Ingenion/tvs3docs/README.md

# Setup

This repo for documentation was created using the steps in the following tutorial.

To get started, follow [this Sphinx tutorial](https://olgarithms.github.io/sphinx-tutorial/).

To create a new Ingenion documentation repo, clone this one and use steps in the tutorial above to setup your local workspace, as needed.

# Building the document
1. ```cd``` to the root folder
2. ```source venv/bin/activate```
3. ```cd docs```
3. ```make html```
4. Open the ```docs/_build/html/index.html``` file
