Ingenion/tvs3docs/docs/overview/module_set.rst

.. _module_set:

Module Set
==========
The following modules are available for the TVS 3.0 mainframe from Ingenion's eStore.  Module templates (electrical and mechanical) are freely provided by Ingenion allowing users to create their own custom modules.

Modules provide the physical interface to the outside world and can be used to add functionality to the TVS 3.0 mainframe.  Modules can be easily swapped in and out of the mainframe allowing users to quickly change the functionality of the system.  Modules are paired with FPGA logic blocks and/or software running on the Raspberry Pi-5 module to provide a complete solution for a wide range of applications. 

SpaceWire I/O Module
--------------------
This module provides SpaceWire-compliant connectors and LVDS transceivers for high-speed serial communication.  The module supports data rates up to 200 Mbps and is ideal for space applications requiring reliable and low-latency communication.

LVDS I/O Module
---------------
This module provides a set of LVDS transceivers and connectors for high-speed differential signaling.  The module supports data rates up to 400 Mbps and is suitable for custom applications requiring high-speed data transfer with low noise and interference.

RS-422 I/O Module
-----------------
This module provides RS-422 transceivers and connectors for differential serial communication.  The module supports data rates up to 10 Mbps and is ideal for industrial and commercial applications requiring robust and long-distance communication.

RS-485 I/O Module
-----------------
This module provides RS-485 transceivers and connectors for differential serial communication.  The module supports data rates up to 10 Mbps and is suitable for industrial and commercial applications requiring multi-point communication over long distances.

LVTTL I/O Module
----------------
This module provides LVTTL transceivers and connectors for single-ended digital signaling.  The module is ideal for general-purpose digital I/O applications.

CAN I/O Module 
--------------
This module provides CAN transceivers and connectors for Controller Area Network (CAN) communication.  The module supports data rates up to 1 Mbps and is ideal for automotive and industrial applications requiring robust and reliable communication.

Ethernet PHY Module
-------------------
This module provides Ethernet PHY and RJ45 connectors for 10/100/1000 Mbps Ethernet communication.  The module is suitable for applications requiring network connectivity and high-speed data transfer.

SpaceFibre I/O Module 
---------------------
This module provides SpaceFibre-compliant connectors and transceivers for high-speed serial communication.  The module supports data rates up to 6.25 Gbps and is ideal for space applications requiring high-bandwidth and low-latency communication.
