Ingenion/tvs3docs/docs/mainframe/pwr_mass_size.rst

Power, Mass, Size
=================

Power 
-----
The TVS 3.0 mainframe requires a +12V DC power supply. Power is received on either J6 or J9 (not both) on the back side of the enclosure.  A minimum current rating of 3A (TBD) is recommended to ensure proper operation.  

Custom modules may be designed to accept additional power inputs, as needed.  Please refer to the module design guidelines for more information regarding grounding and IO standards.

Mass 
----
The TVS 3.0 mainframe has a mass of approximately 3 kg (TBD).  This only includes the mainframe enclosure without any modules.

Size 
----
The TVS 3.0 mainframe has the following dimensions: 
   - Height: 3u - 5.25" (133.35 mm)
   - Width:  19" (482.6 mm)
   - Depth:  6.89" (175mm)

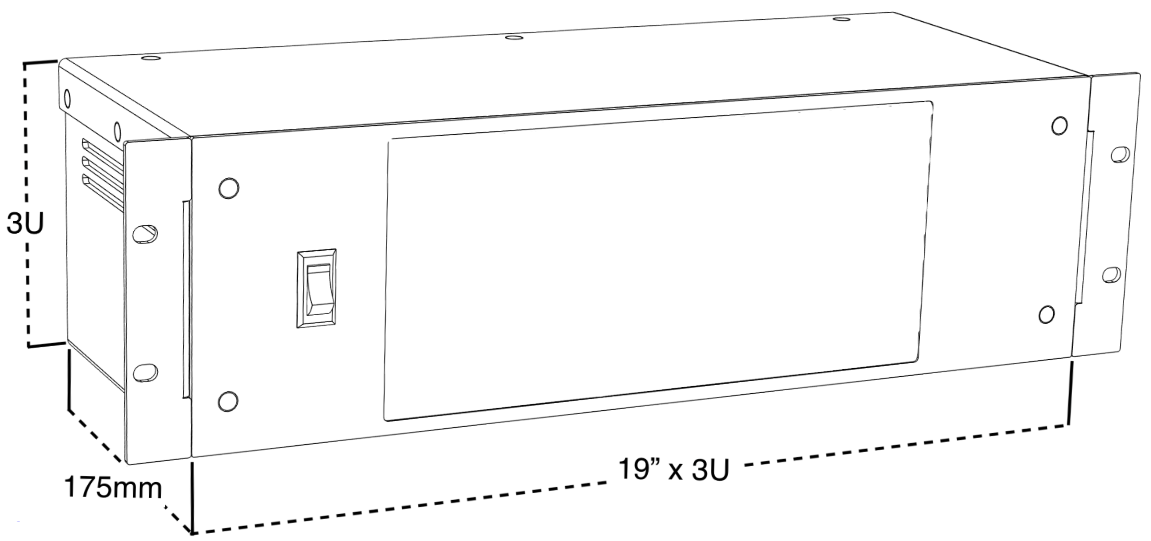
[picture p2: images/pwr_mass_size/enclosure/angled.png]


Mounting Options 
----------------
The TVS 3.0 mainframe can be mounted in a standard 19" equipment rack using the optional rack ears and hardware.  

Without rack ears the mainframe is used on a benchtop or other non-rack environment.
