Ingenion/tvs3docs/docs/modules/module_template.rst

.. _module_template:

Module Template
===============

Board Outline
-------------

Power
-----

Edge Connector and Pinout
-------------------------
While the bit file is loaded into the FPGA, pins are floating.  Be sure to design the module with pull-ups or pull-downs to prevent any undesired effects.

Connector Plate
---------------

Engineering Files
-----------------
