Ingenion/tvs3docs/docs/modules/analog_in.rst

Analog Inputs 
=============

Features
--------

Connectors
----------

Operation
---------
