Ingenion/tvs3docs/docs/modules/analog_out.rst

Analog Outputs 
==============

Features
--------

Connectors
----------

Operation
---------
