Ingenion/tvs3docs/docs/modules/can.rst

CAN 
===

Features
--------

Connectors
----------

Operation
---------
