Ingenion/tvs3docs/docs/modules/ethernet.rst

Gigabit Ethernet Module
=======================

Features
--------

Connectors
----------

Operation
---------
