Ingenion/tvs3docs/docs/modules/lvds.rst

LVDS Module
===========

Features
--------

Connectors
----------

Operation
---------
