Ingenion/tvs3docs/docs/modules/lvttl.rst

LVTTL 
=====

Features
--------

Connectors
----------

Operation
---------
