Ingenion/tvs3docs/docs/modules/rs422.rst

RS-422 
======

Features
--------

Connectors
----------

Operation
---------
