Ingenion/tvs3docs/docs/modules/rs485.rst

RS-485 
======

Features
--------

Connectors
----------

Operation
---------
