Ingenion/tvs3docs/docs/modules/spacefibre.rst

SpaceFibre Module
=================

Features
--------

Connectors
----------

Operation
---------
