Ingenion/tvs3docs/docs/modules/spacewire.rst

SpaceWire
=========

Features
--------

Connectors
----------

Operation
---------
