Ingenion/tvs3docs/images/3d-models/module_pcb_dims.pdf

150

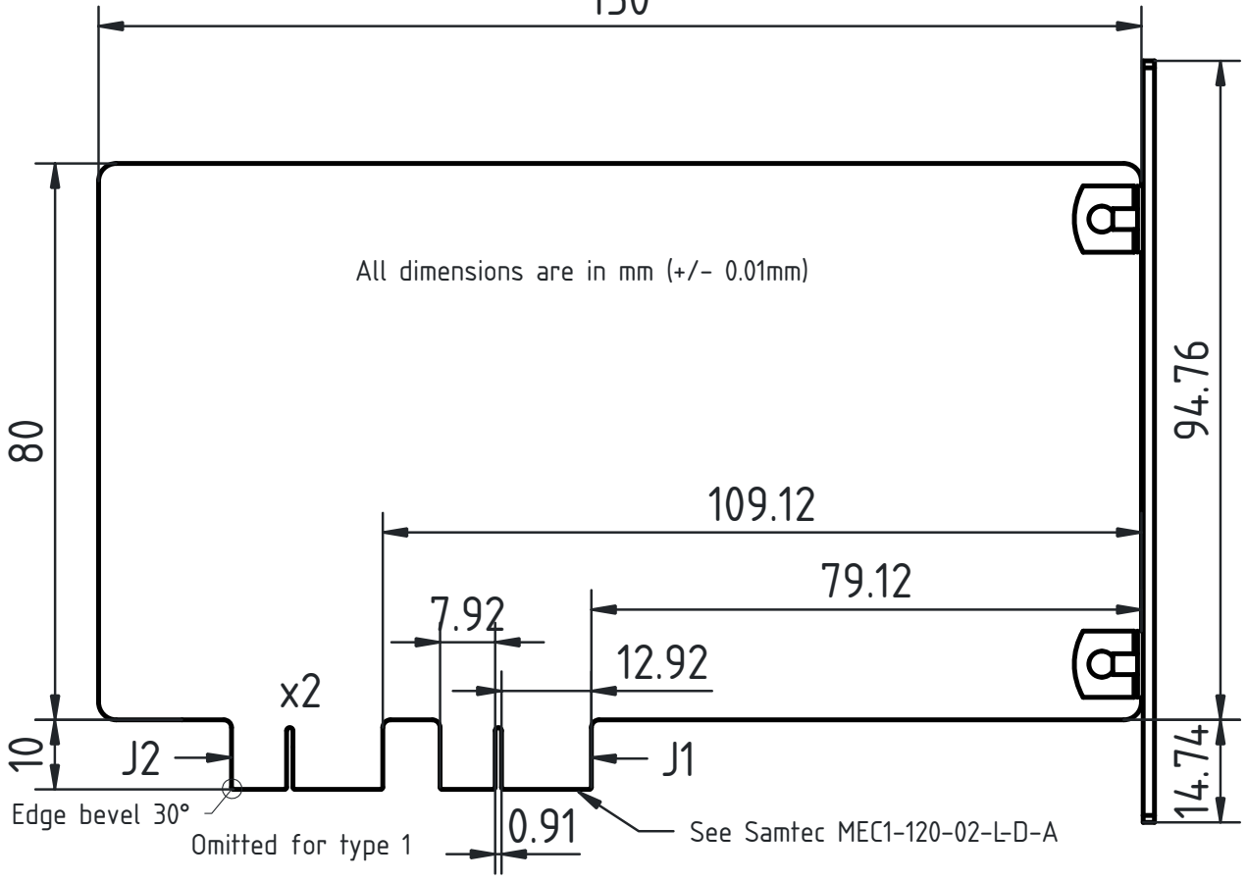
[picture p3: figure]
All dimensions are in mm (+/- 0.01mm); Edge bevel 30°

See Samtec MEC1-120-02-L-D-A Omitted for type 1
