Ingenion/tvs3docs/images/pwr_mass_size/enclosure/angled.pdf

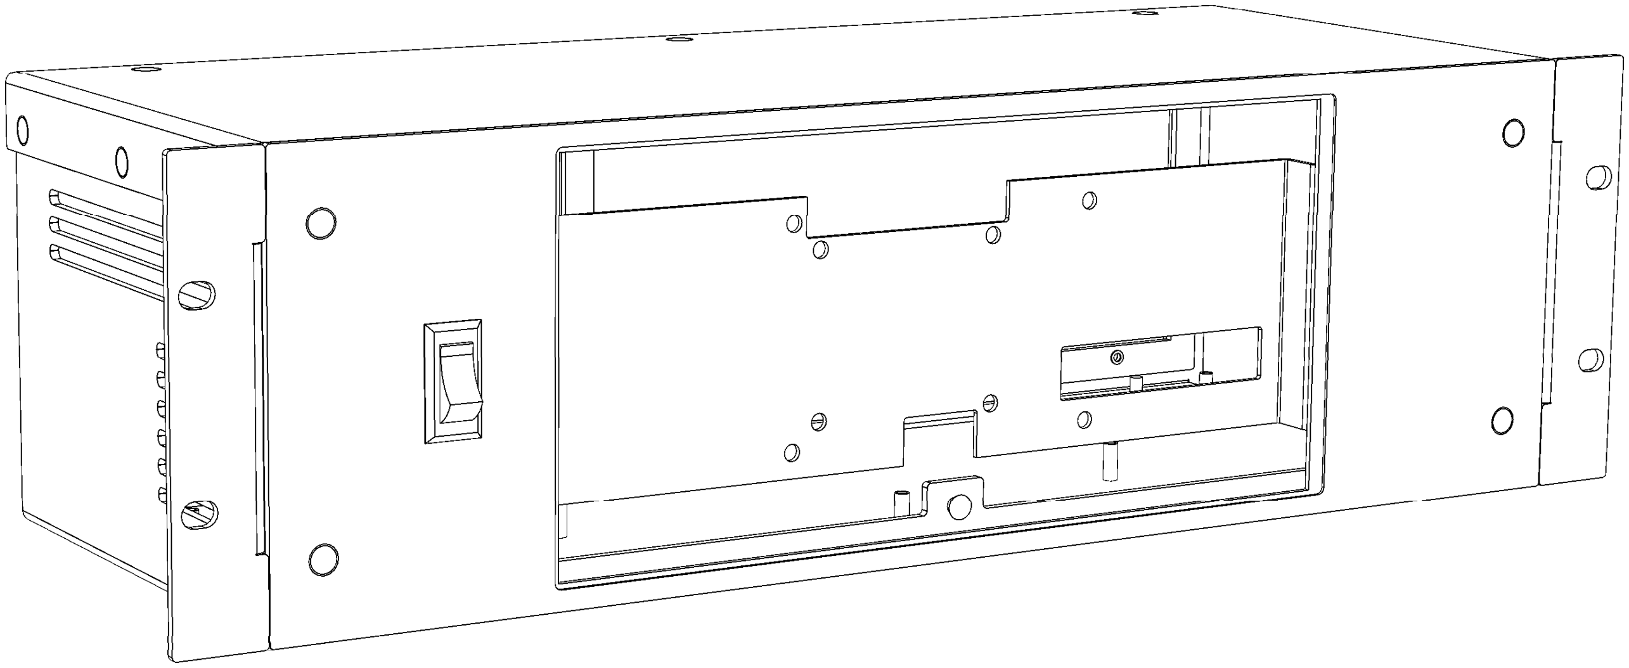
[picture p18: figure]
