Ingenion/tvs3docs/images/pwr_mass_size/enclosure/back.pdf

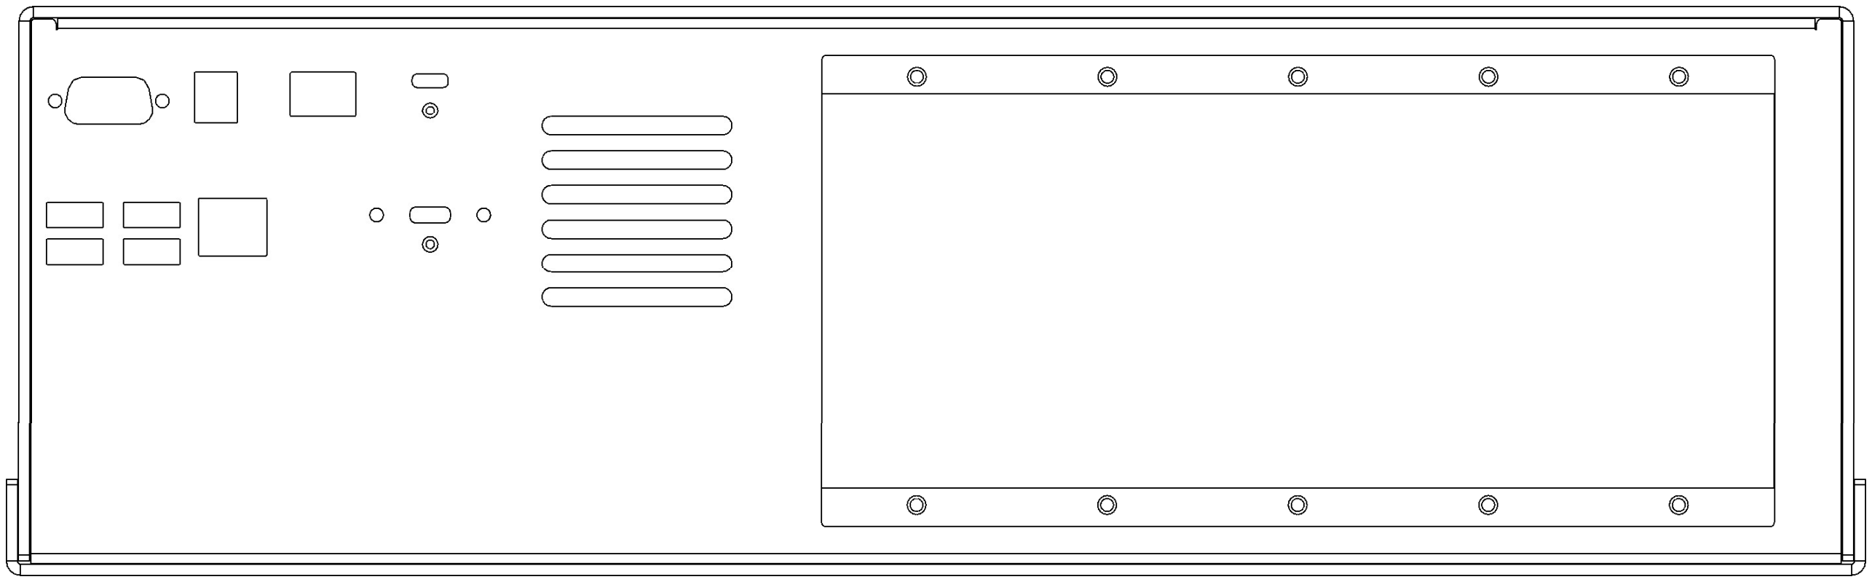
[picture p19: figure]
