Ingenion/tvs3docs/images/pwr_mass_size/enclosure/left.pdf

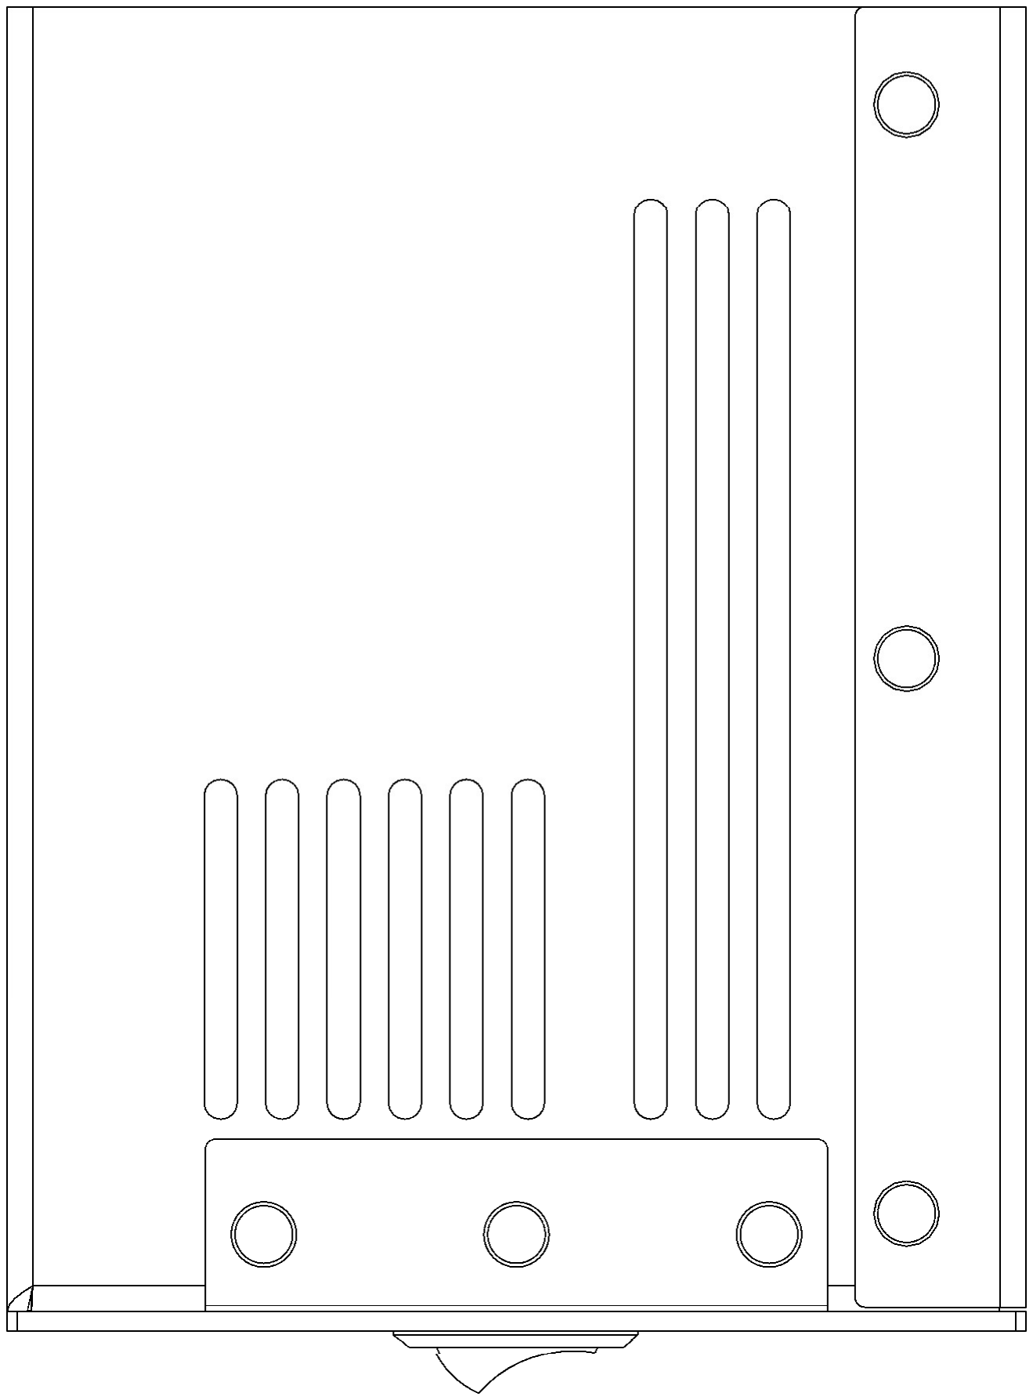
[picture p21: figure]
