Ingenion/tvs3docs/images/pwr_mass_size/enclosure/right.pdf

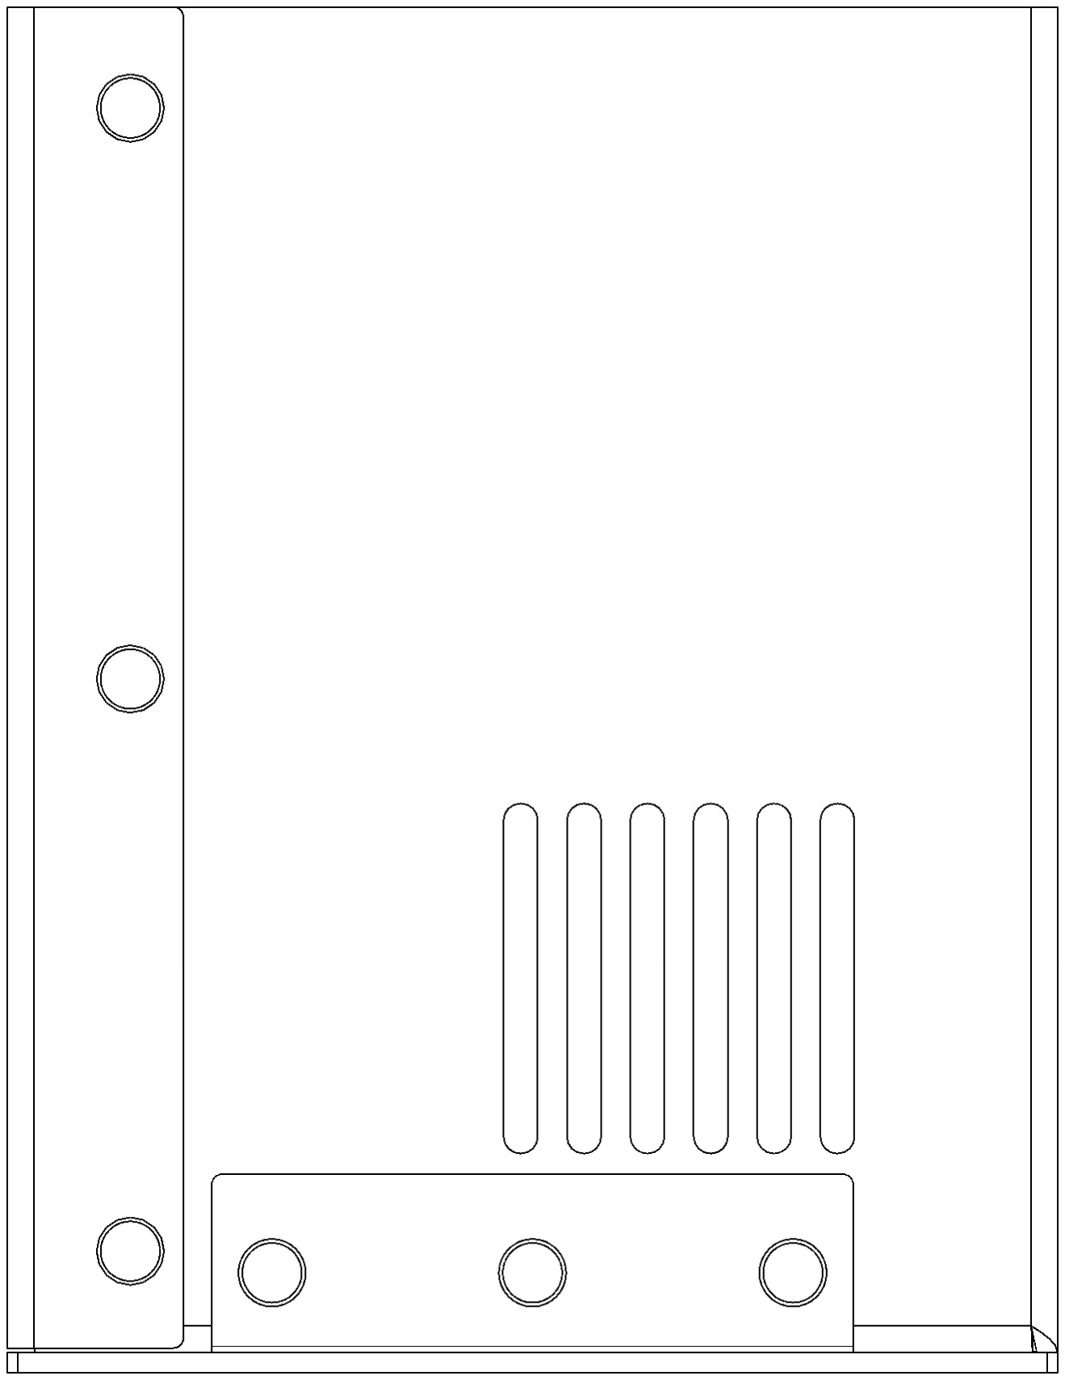
[picture p22: figure]
