Ingenion/tvs3docs/images/pwr_mass_size/enclosure/top.pdf

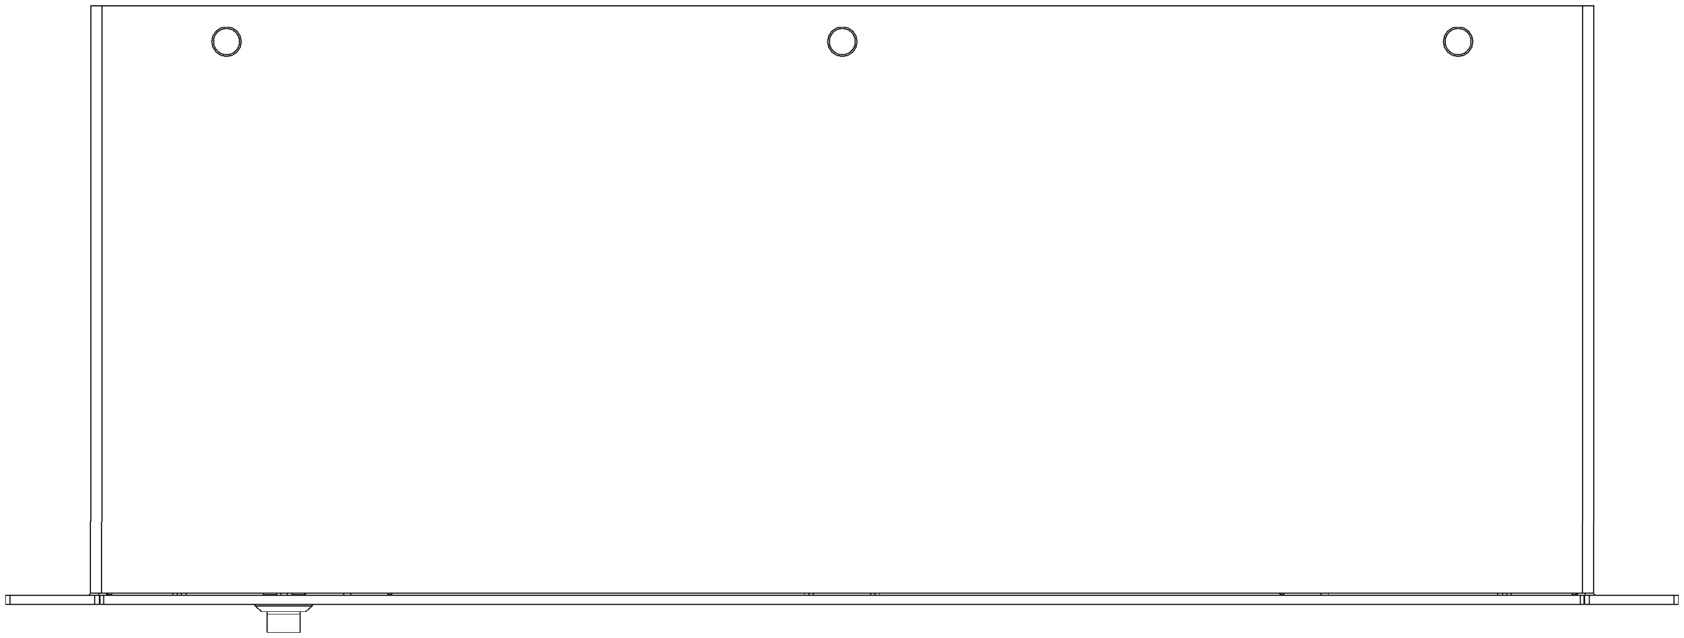
[picture p23: figure]
