Ingenion/tvs3docs/images/mainframe/module_envelope.png

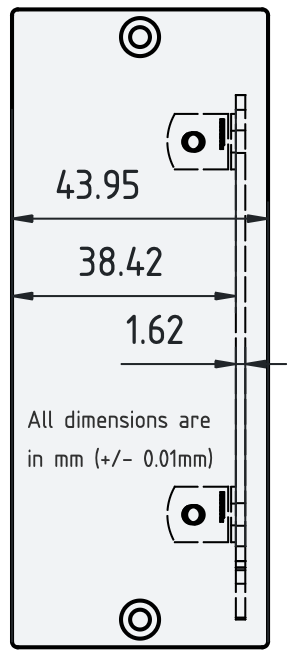
images/mainframe/module_envelope.png
