Ingenion/tvs3docs/images/pwr_mass_size/enclosure/back.png

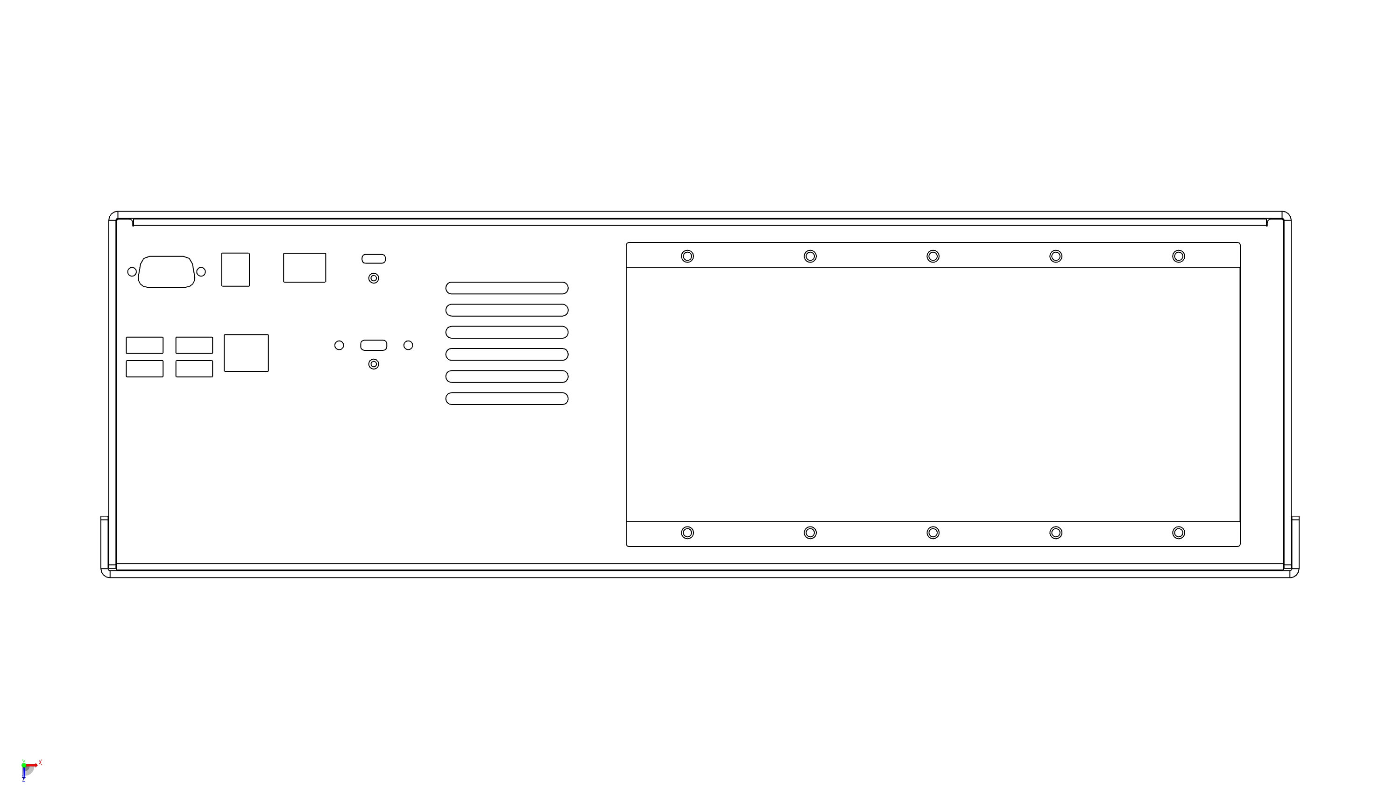
images/pwr_mass_size/enclosure/back.png
