Ingenion/tvs3docs/images/pwr_mass_size/enclosure/front.png

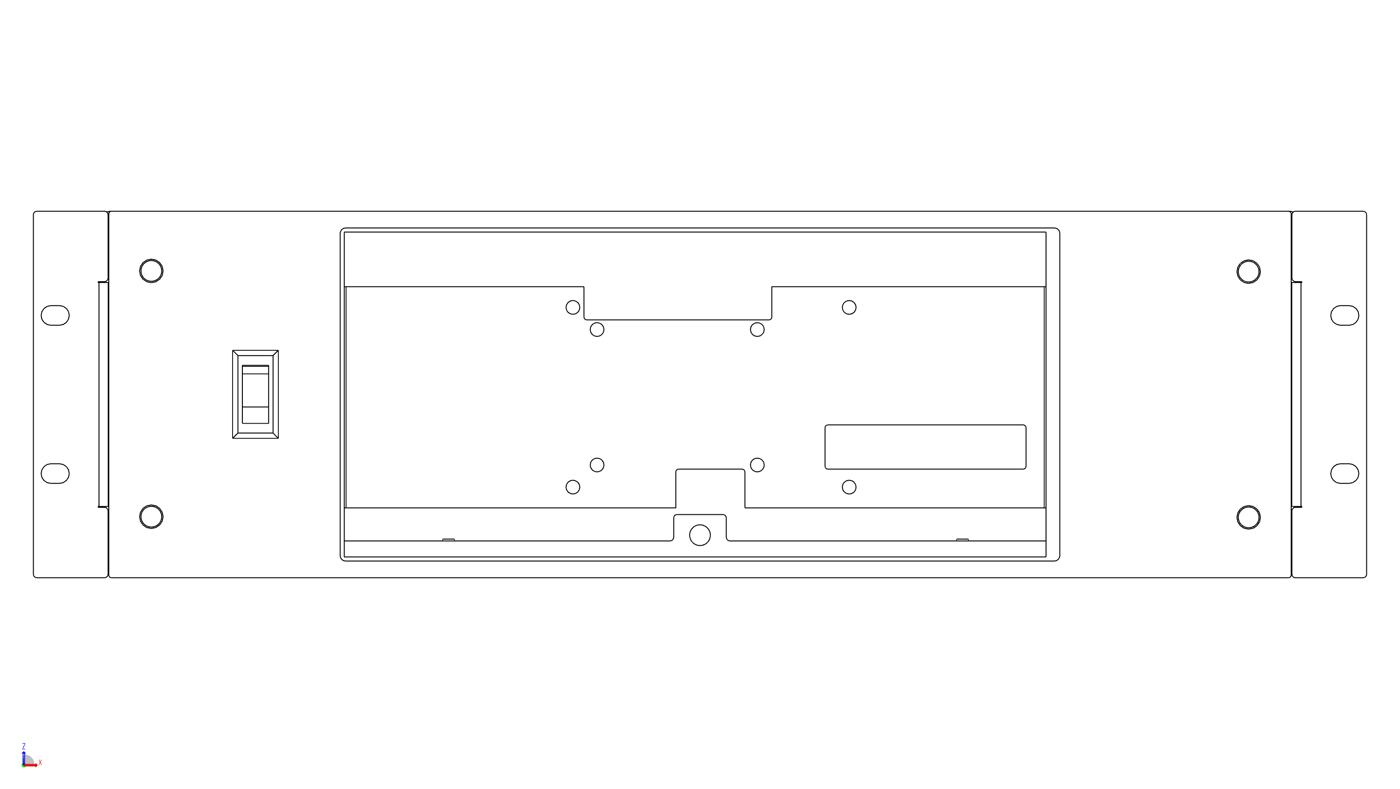
images/pwr_mass_size/enclosure/front.png
