Ingenion/tvs3docs/images/pwr_mass_size/enclosure/left.png

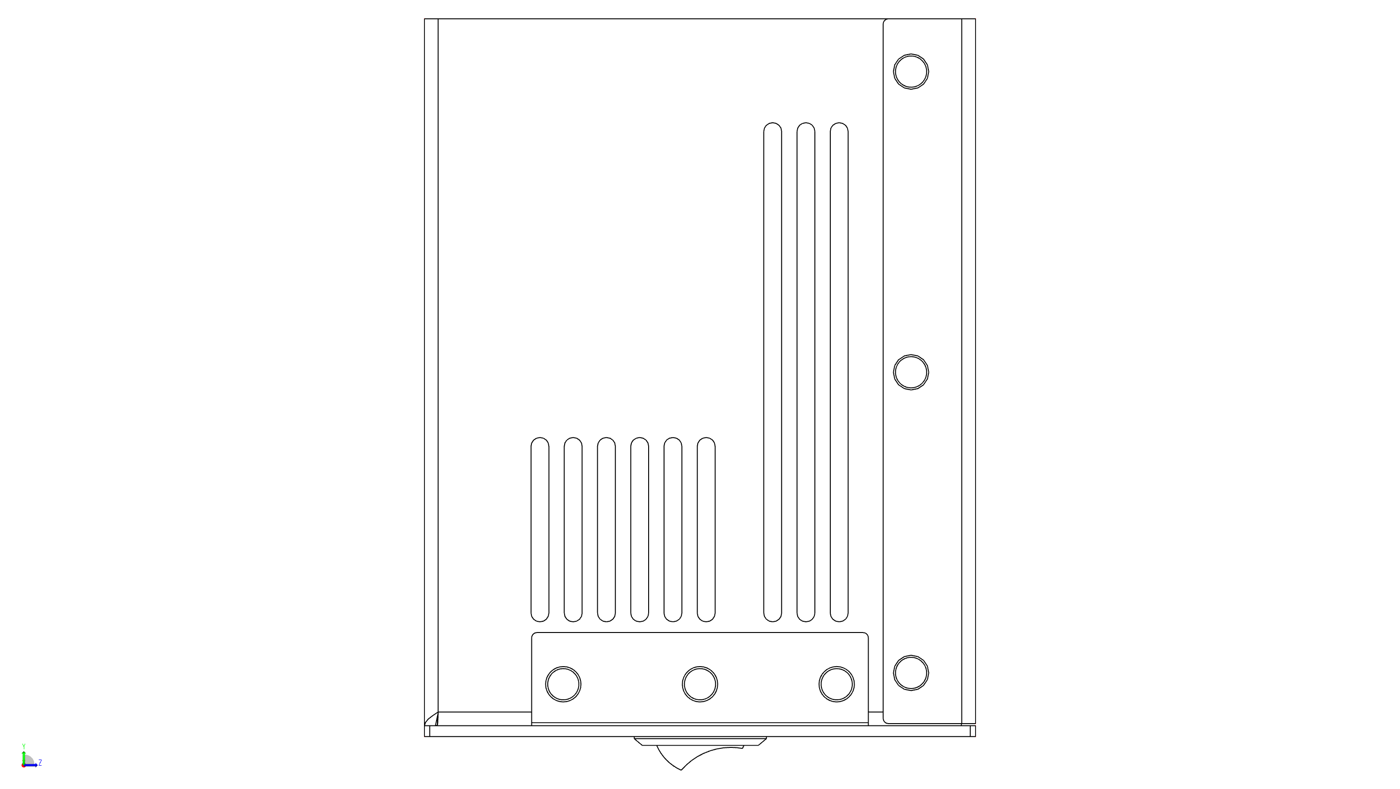
images/pwr_mass_size/enclosure/left.png
