Ingenion/tvs3docs/images/pwr_mass_size/enclosure/right.png

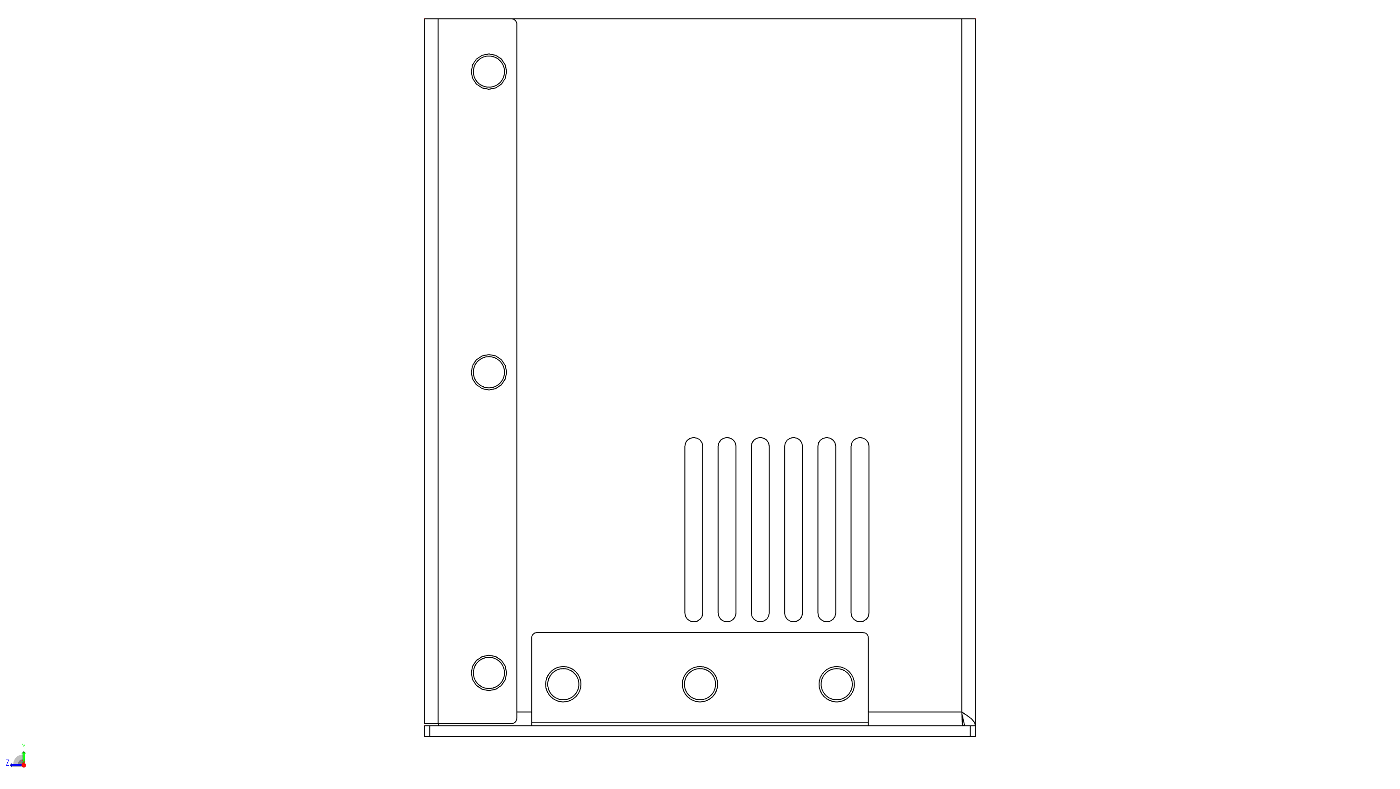
images/pwr_mass_size/enclosure/right.png
