Ingenion/tvs3docs/images/pwr_mass_size/enclosure/top.png

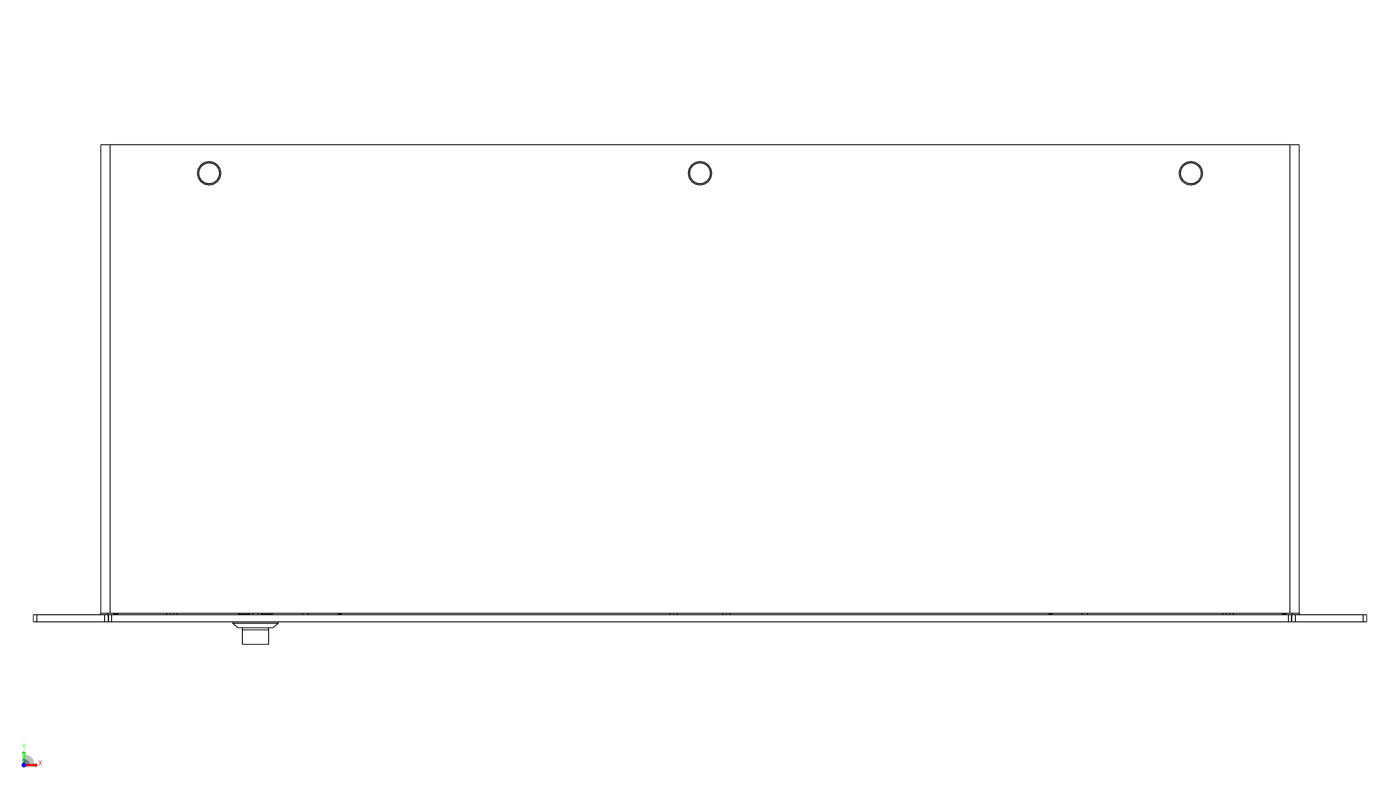
images/pwr_mass_size/enclosure/top.png
