Ingenion/tvs3docs/images/3d-models/MainFrame.FCStd

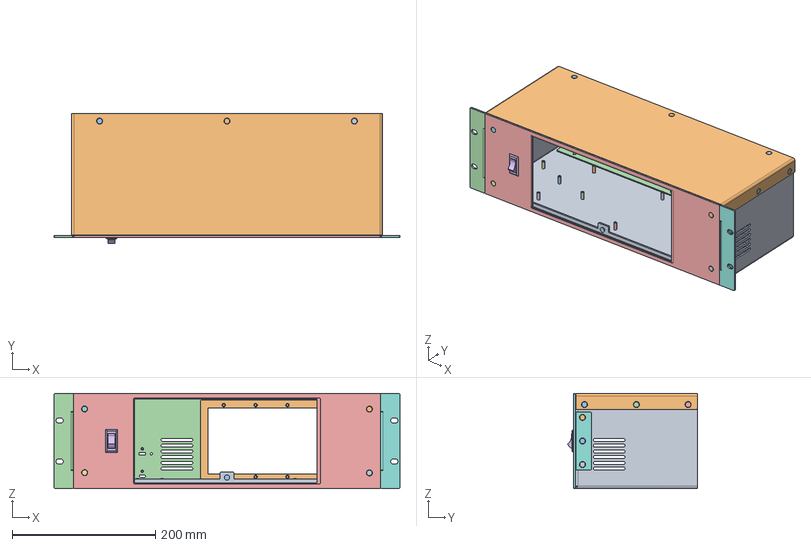
[picture p30: CAD file, 2026-02-25]
images/3d-models/MainFrame.FCStd
482.6 x 180.7 x 132.6 mm
Chassis
SP-M4-1
SP-M4-002
SP-M4-003
SP-M4-004
SP-M4-005
SP-M4-006
SP-M4-007
SP-M4-008
SP-M4-009
SP-M4-010
SP-M4-011
SP-M4-012
SP-M4-013
SP-M4-014
SP-M4-015
SP-M4-016
SP-M4-017
BSO4-M3-14
BSO4-M3-015
BSO4-M3-016
BSO4-M3-017
BSO4-M3-018
BSO4-M3-019
BSO4-M3-020
BSO4-M3-021
BSO4-M3-022
BSO4-M3-023
BSO4-M3-024
BSO4-M3-025
FH4-M4-10
FH4-M4-011
FH4-M4-012
Cover
m4_6mm_stainless_phillips_flathead_screw
m4_6mm_stainless_phillips_flathead_screw001
m4_6mm_stainless_phillips_flathead_screw002
m4_6mm_stainless_phillips_flathead_screw003
m4_6mm_stainless_phillips_flathead_screw004
m4_6mm_stainless_phillips_flathead_screw005
m4_6mm_stainless_phillips_flathead_screw006
m4_6mm_stainless_phillips_flathead_screw007
m4_6mm_stainless_phillips_flathead_screw008
Rear
SP-M4-018
SP-M4-019
SP-M4-020
U-M2-1
U-M2-002
Panel
FEX-M3
FEX-M004
FEX-M005
FEX-M006
FEX-M007
FEX-M008
FEX-M009
FEX-M010
FEX-M011
FEX-M012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
