Ingenion/tvs3docs/images/3d-models/module_PCB.step

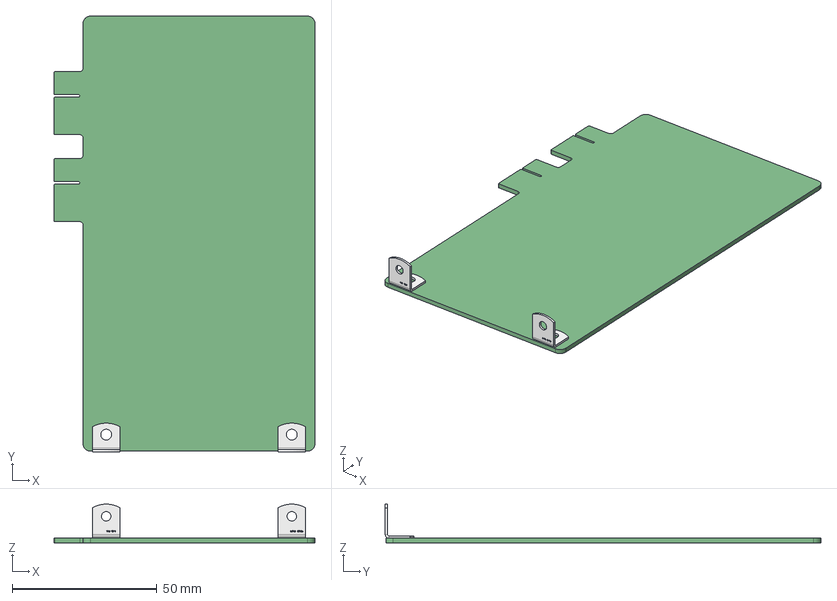
[picture p32: CAD file, 2026-02-25]
images/3d-models/module_PCB.step
90.0 x 150.2 x 13.4 mm
613--3DModel-STEP-630548 x 2
Keystone x 2
