Ingenion/tvs3docs/images/3d-models/module-template-type2.FCStd

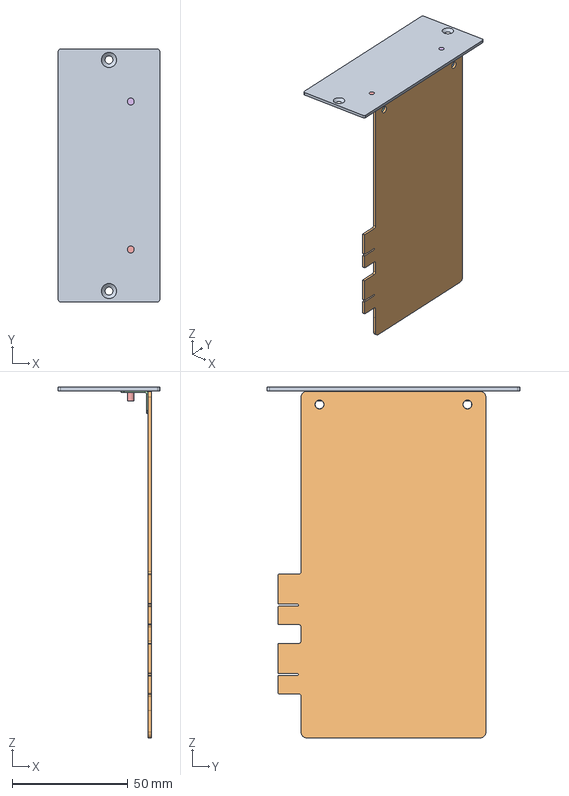
[picture p33: CAD file, 2026-02-25]
images/3d-models/module-template-type2.FCStd
43.9 x 109.5 x 151.9 mm
Panel
FH-M3-6ZI
FH-M3-6ZI001
