Ingenion/tvs3docs/images/3d-models/enclosure.obj

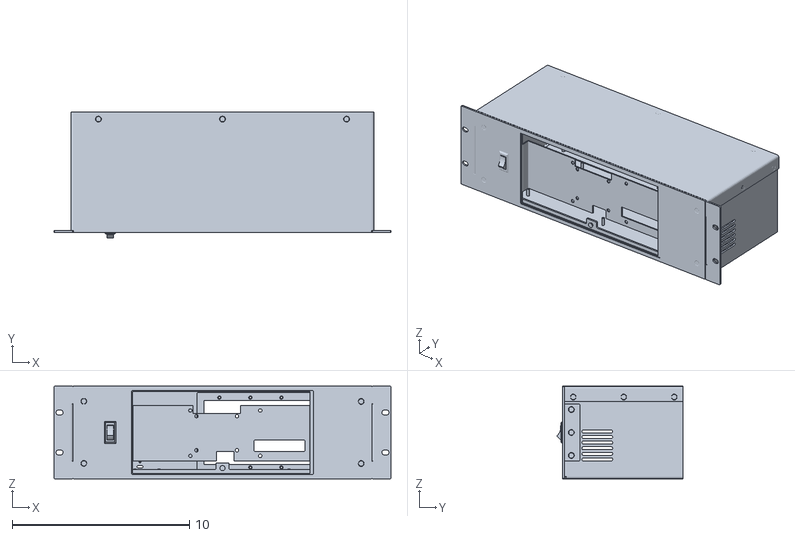
[picture p34: CAD file, 2026-02-25]
images/3d-models/enclosure.obj
19.0 x 7.11 x 5.22
