Ingenion/tvs3docs/images/3d-models/module.stp

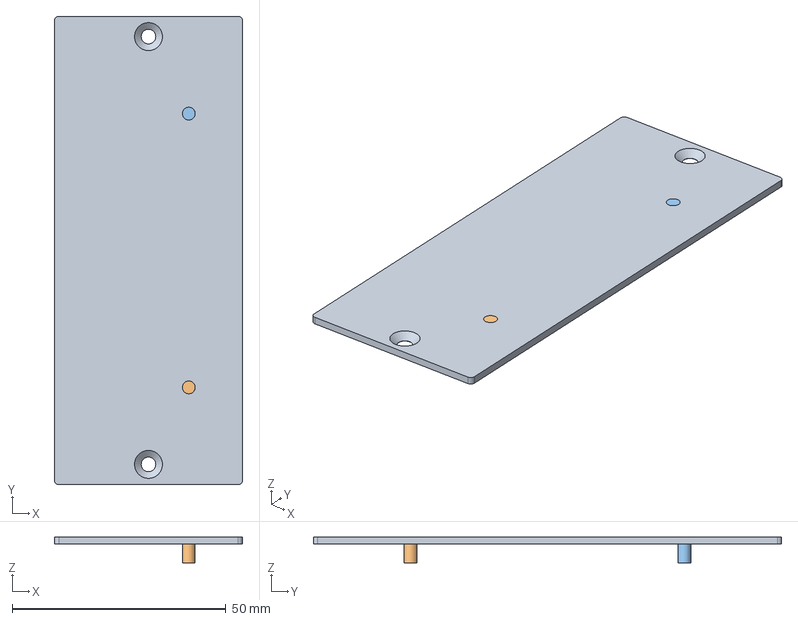
[picture p35: CAD file, 2026-02-25]
images/3d-models/module.stp
43.9 x 109.5 x 6.00 mm
Panel
FH-M3-6ZI x 2
