Ingenion/tvs3docs/(list of files, cad)

Other CAD files:
images/3d-models/TVS 3.0 - Slot View.FCStd
images/3d-models/module.obj
