Ingenion/tvs3docs/images/3d-models/slot_view.pdf

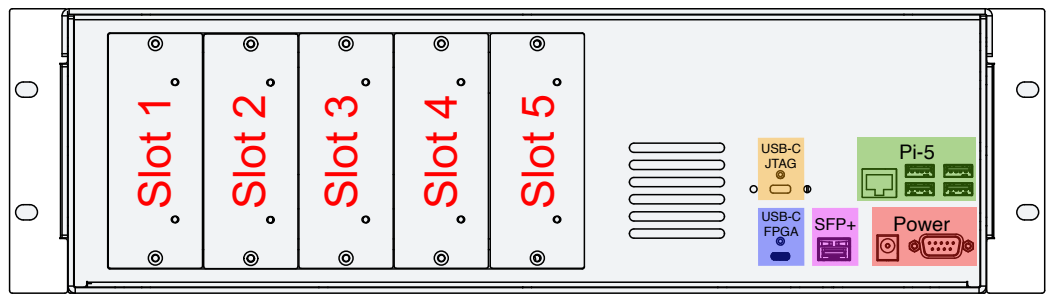
[picture p36: page 1]
Slot 2; Slot 3; Slot 4; Slot 5; Slot 1
