Ingenion/tvs3docs/images/3d-models/module_envelope.pdf

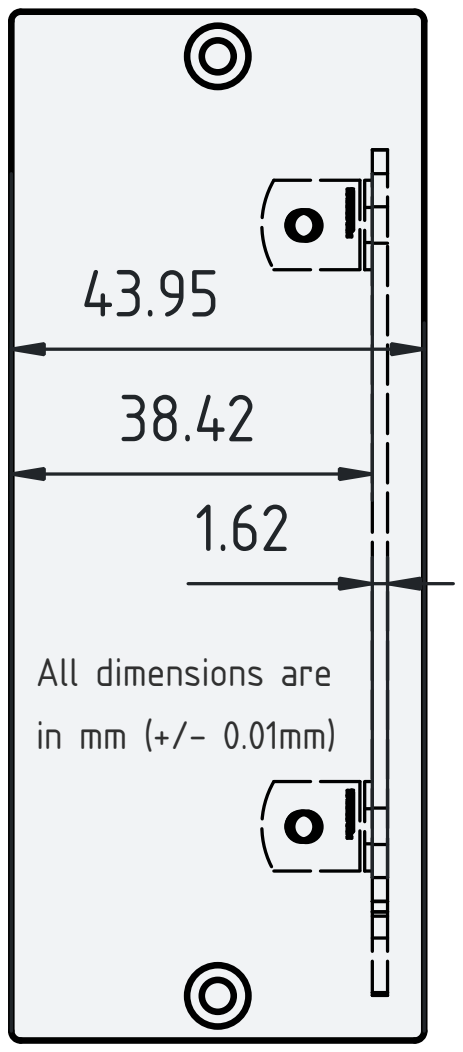
[picture p37: page 1]

All dimensions are
