Ingenion/tvs3docs/(commit log)

2025-03-26 Added Prototype/Emulation Section
2025-10-01 Added initial mass power size content
2025-11-09 Adding power mass size info
2025-11-15 Testing embedded xlsx file
    [MC1.xlsx]
2025-11-24 Adding IO planning spreadsheet
    [MC1.xlsx, tvs3_io_planning.xlsx]
2025-11-24 protected sheets with PW: Ingenion
    [tvs3_io_planning.xlsx]
2026-02-25 Completed interfaces page.
    [MainFrame.FCStd, TVS 3.0 - Slot View.FCStd, enclosure Rev(-).step, enclosure.obj, module-template-type2.FCStd, module.obj, module.stp, module_PCB.step]
